retrorgb/COMP2DVI/Renders/comp2dvi2.1 Top no parts.png

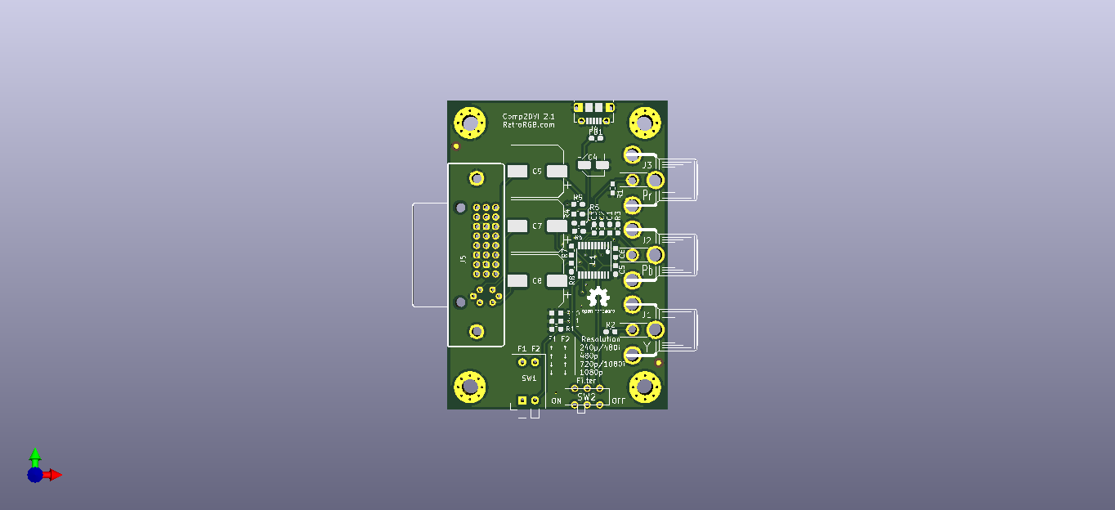
Renders/comp2dvi2.1 Top no parts.png
