retrorgb/COMP2DVI/README.md

# COMP2DVI
Please refer to the [COMP2DVI](https://www.retrorgb.com/comp2dvi.html) page on RetroRGB for more information.
