retrorgb/COMP2DVI/Renders/comp2dvi2.1 top.png

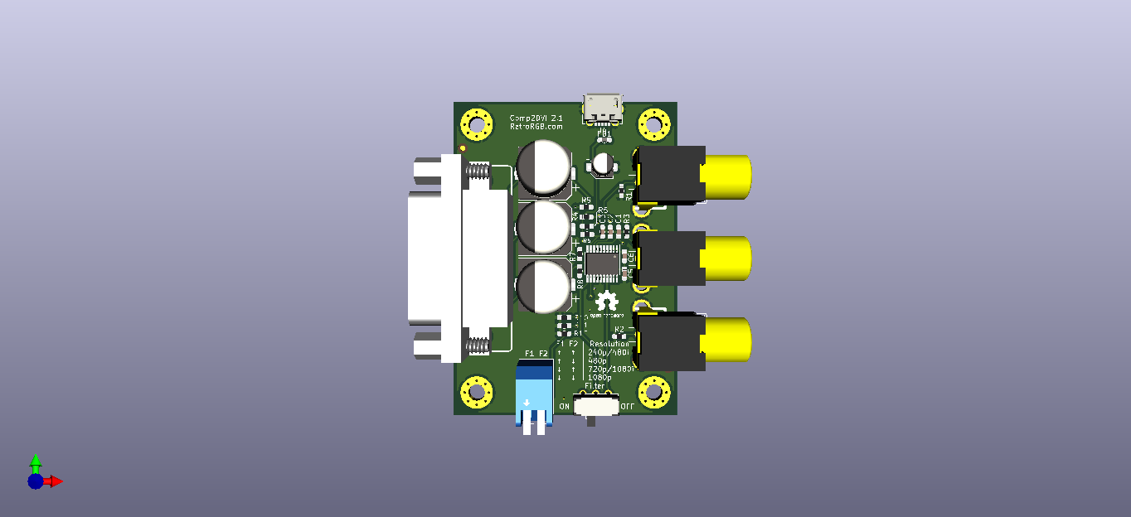
Renders/comp2dvi2.1 top.png
