retrorgb/COMP2DVI/COMP2DVI_BOM.xlsx

Qty | Reference(s) | Value | Footprint | Description | Digikey | Arrow | LCSC | Alternate Parts
4 | C1, C2, C3, C5 | 100nF/0.1uF | 0603 | Ceramic 50V X7R | https://www.digikey.com/product-detail/en/CL10F104ZO8NNNC/1276-1258-1-ND/3889344/ | https://www.arrow.com/en/products/cl10f104zo8nnnc/samsung-electro-mechanics | https://lcsc.com/product-detail/Multilayer-Ceramic-Capacitors-MLCC-SMD-SMT_100nF-104-10-50V_C14663.html
1 | C4 | 10 uF | 4x5.4 | Elec. 25-50V | https://www.digikey.com/product-detail/en/panasonic-electronic-components/EEE-FK1E100R/PCE3795CT-ND/766171 | https://www.arrow.com/en/products/eeefk1e100r/panasonic | https://lcsc.com/product-detail/Others_PANASONIC-EEE1EA100WAR_C336730.html
1 | C6 | 10nF | 0603 | Ceramic 50V X7R | https://www.digikey.com/product-detail/en/samsung-electro-mechanics/CL10B103KB8NCNC/1276-1921-1-ND/3890007 | https://www.arrow.com/en/products/cc0603krx7r9bb103/yageo | https://lcsc.com/product-detail/Others_Samsung-Electro-Mechanics_CL10B103KB8NFNC_Samsung-Electro-Mechanics-CL10B103KB8NFNC_C307477.html
3 | C7, C8, C9 | 470uF | 10x10 | Elec. 25V | https://www.digikey.com/product-detail/en/nichicon/UCW1E471MNL1GS/493-9424-1-ND/3962772 | https://www.arrow.com/en/products/uwg1e471mnl1gs/nichicon | https://lcsc.com/product-detail/Others_Nichicon-UCW1E471MNL1GS_C340751.html
1 | FB1 | 220Ω | 0603 | Ferrite Bead | https://www.digikey.com/product-detail/en/tdk-corporation/MPZ1608S221ATA00/445-1565-1-ND/571895 | https://www.arrow.com/en/products/mpz1608s221ata00/tdk | https://lcsc.com/product-detail/Ferrite-Beads-And-Chips_TDK_MPZ1608S221ATA00_220R-25-at100MHz_C76815.html
6 | R1, R2, R3, R7, R8, R9 | 75Ω | 0603 | 1% | https://www.digikey.com/product-detail/en/rohm-semiconductor/ESR03EZPF75R0/RHM75.0ADCT-ND/1983773 | https://www.arrow.com/en/products/erj-3ekf75r0v/panasonic | https://lcsc.com/product-detail/Chip-Resistor-Surface-Mount_75R-75R0-1_C112309.html
3 | R4, R5, R6 | 5.36M | 0603 | 1% | https://www.digikey.com/product-detail/en/vishay-dale/CRCW06035M36FKEA/541-5.36MHCT-ND/1180235 | https://www.arrow.com/en/products/crcw06035m36fkea/vishay |  | not available from lcsc
3 | R10, R11, R12 | 100K | 0603 | 1% | https://www.digikey.com/product-detail/en/yageo/RC0603FR-07100KL/311-100KHRCT-ND/729836 | https://www.arrow.com/en/products/erj-3ekf1003v/panasonic | https://lcsc.com/product-detail/Chip-Resistor-Surface-Mount_100KR-1003-1_C14675.html
1 | U1 | THS7368 | TSSOP-20 |  | https://www.digikey.com/product-detail/en/texas-instruments/THS7368IPWR/296-25625-1-ND/2202289 | https://www.arrow.com/en/products/ths7368ipw/texas-instruments | https://lcsc.com/product-detail/Operational-Amplifiers_TI_THS7368IPW_THS7368IPW_C206127.html
1 | SW1 | DIP Switch | 1x2 DIP | Piano | https://www.digikey.com/product-detail/en/omron-electronics-inc-emc-div/A6FR-2104/Z8808-ND/8575965 | https://www.arrow.com/en/products/a6fr2104/omron | https://lcsc.com/product-detail/DIP-Switches_Made-in-China-VPG1S-02H-R_C12544.html
1 | SW2 | Microswitch | SPDT |  | https://www.digikey.com/product-detail/en/c-k/JS202011AQN/401-2000-ND/1640096 | https://www.arrow.com/en/products/js202011aqn/ck | https://lcsc.com/product-detail/Toggle-Switches_C-K_JS202011AQN_C-K-JS202011AQN_C221662.html
1 | J1 | RCA Jack | 4 pin | Y (Green) | https://www.digikey.com/product-detail/en/RCJ-016/CP-1405-ND/408492/ | https://www.arrow.com/en/products/rcj-016/cui-inc
2 | J2 | RCA Jack | 4 pin | Pb (Blue) | https://www.digikey.com/product-detail/en/RCJ-015/CP-1404-ND/408491 | https://www.arrow.com/en/products/rcj-015/cui-inc
3 | J3 | RCA Jack | 4 pin | Pr (Red) | https://www.digikey.com/product-detail/en/cui-inc/RCJ-012/CP-1401-ND/408488 | https://www.arrow.com/en/products/rcj-012/cui-inc
1 | J4 | Micro USB | Micro USB |  | https://www.digikey.com/product-detail/en/molex/1050170001/WM1399CT-ND/2350885 | https://www.arrow.com/en/products/1050170001/molex | https://lcsc.com/product-detail/USB-Connectors_XKB-Enterprise-U254-051T-4BH23-S2B_C319164.html
1 | J5 | DVI-I | DVI-I |  | https://www.digikey.com/product-detail/en/molex-llc/0743201004/WM5600-ND/356066 | https://www.arrow.com/en/products/0743201004/molex | https://lcsc.com/product-detail/Audio-Video-Connectors_CONNFLY-Elec-DS1091-VN0X_C77847.html
2 | DVI SCREWS |  | #4 |  | https://www.digikey.com/product-detail/en/te-connectivity-amp-connectors/5207953-3/5207953-3-ND/1121976 | https://www.arrow.com/en/products/5207953-3/te-connectivity
 | Case Parts
4 | Top Standoffs | nylon | 12mm | M3 | https://www.digikey.com/en/supplier-centers/k/keystone-electronics |  | https://lcsc.com/product-detail/Studs_HIWA-HP-12M3-12_C123697.html | Brass is also ok
4 | Bottom Standoffs | nylon | 5mm | M3 | https://www.digikey.com/product-detail/en/harwin-inc/R30-6700594/952-1528-ND/2264509 |  | https://lcsc.com/product-detail/Studs_HIWA-HP-5M3-5_C123700.html
4 | bottom screws |  | 12mm | M3 | https://www.digikey.com/en/supplier-centers/a/apm-hexseal |  | https://lcsc.com/product-detail/Screw_Shuntian-PM3X12_C357546.html
4 | top screws |  | 8mm | M3 | https://www.digikey.com/en/supplier-centers/a/apm-hexseal |  | https://lcsc.com/product-detail/Screw_Shuntian-PM3X8_C357544.html
4 | rubber feet |  |  | M3 | https://www.digikey.com/product-detail/en/keystone-electronics/720/36-720-ND/61956 |  |  | https://www.amazon.com/gp/product/B07MBN4WSR/ref=ppx_yo_dt_b_search_asin_title?ie=UTF8&psc=1
