retrorgb/COMP2DVI/comp2dvi2.kicad_pcb

## KiCad design comp2dvi2.kicad_pcb (2019-06-26)

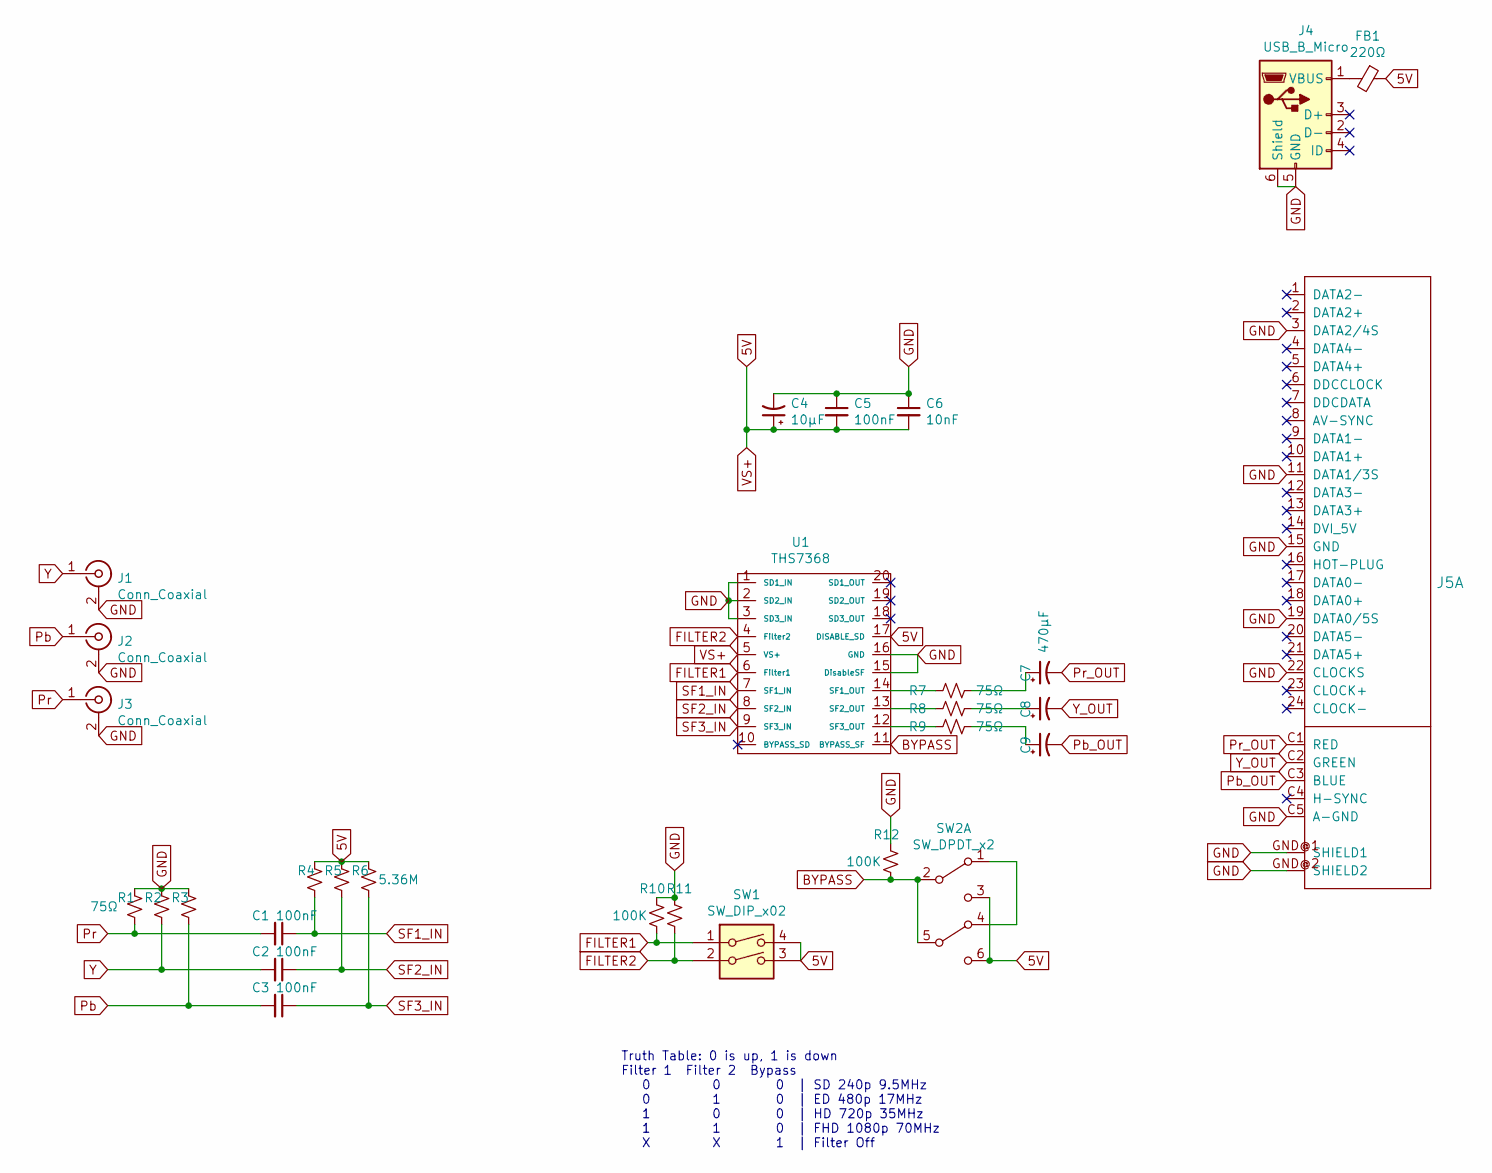
[picture p3: schematic comp2dvi2.sch, VGA2DVI]

Parts:
C1, C2, C3, C5: 100nF; C_0603_1608Metric_Pad1.05x0.95mm_HandSolder
C4: 10μF; CP_Elec_4x5.4
C6: 10nF; C_0603_1608Metric_Pad1.05x0.95mm_HandSolder
C7, C8, C9: 470μF; CP_Elec_10x10
FB1: 220Ω; L_0603_1608Metric_Pad1.05x0.95mm_HandSolder
J1, J2, J3: Conn_Coaxial; CIU_RCJ-01X
J4: USB_B_Micro; USB_Micro-B_Molex-105017-0001
J5: DVI-I-R
R1, R2, R3, R7, R8, R9: 75Ω; R_0603_1608Metric_Pad1.05x0.95mm_HandSolder
R4, R5, R6: 5.36M; R_0603_1608Metric_Pad1.05x0.95mm_HandSolder
R10, R11, R12: 100K; R_0603_1608Metric_Pad1.05x0.95mm_HandSolder
SW1: SW_DIP_x02; SW_DIP_SPSTx02_Piano_10.8x6.64mm_W7.62mm_P2.54mm
SW2: SW_DPDT_x2; JS202011
U1: THS7368; TSSOP-20_4.4x6.5mm_P0.65mm

Connections:
5V: C4.1, C5.2, C6.2, FB1.1, R4.1, R5.1, R6.1, SW1.3, SW1.4, SW2.3 (C), SW2.6 (C), U1.5 (VS+), U1.17 (DISABLE_SD)
BYPASS: R12.2, SW2.2 (B), SW2.5 (B), U1.11 (BYPASS_SF)
FILTER1: R10.2, SW1.1, U1.6 (Filter1)
FILTER2: R11.2, SW1.2, U1.4 (Filter2)
GND: C4.2, C5.1, C6.1, J1.2 (Ext), J2.2 (Ext), J3.2 (Ext), J4.5 (GND), J4.6 (Shield), J5.3 (DATA2/4S), J5.11 (DATA1/3S), J5.15 (GND), J5.19 (DATA0/5S), J5.22 (CLOCKS), J5.C5 (A-GND), J5.GND@1 (SHIELD1), J5.GND@2 (SHIELD2), R1.1, R2.1, R3.1, R10.1, R11.1, R12.1, U1.1 (SD1_IN), U1.2 (SD2_IN), U1.3 (SD3_IN), U1.15 (DisableSF), U1.16 (GND)
unnamed: C7.1, R7.1
unnamed: C8.1, R8.1
unnamed: C9.1, R9.1
unnamed: FB1.2, J4.1 (VBUS)
unnamed: R7.2, U1.14 (SF1_OUT)
unnamed: R8.2, U1.13 (SF2_OUT)
unnamed: R9.2, U1.12 (SF3_OUT)
unnamed: SW2.1 (A), SW2.4 (A)
Pb: C3.2, J2.1 (In), R3.2
Pb_OUT: C9.2, J5.C3 (BLUE)
Pr: C1.2, J3.1 (In), R1.2
Pr_OUT: C7.2, J5.C1 (RED)
SF1_IN: C1.1, R4.2, U1.7 (SF1_IN)
SF2_IN: C2.1, R5.2, U1.8 (SF2_IN)
SF3_IN: C3.1, R6.2, U1.9 (SF3_IN)
Y: C2.2, J1.1 (In), R2.2
Y_OUT: C8.2, J5.C2 (GREEN)

Notes on the sheet:
Truth Table: 0 is up, 1 is down Filter 1 Filter 2 Bypass 0 0 0 | SD 240p 9.5MHz 0 1 0 | ED 480p 17MHz 1 0 0 | HD 720p 35MHz 1 1 0 | FHD 1080p 70MHz X X 1 | Filter Off

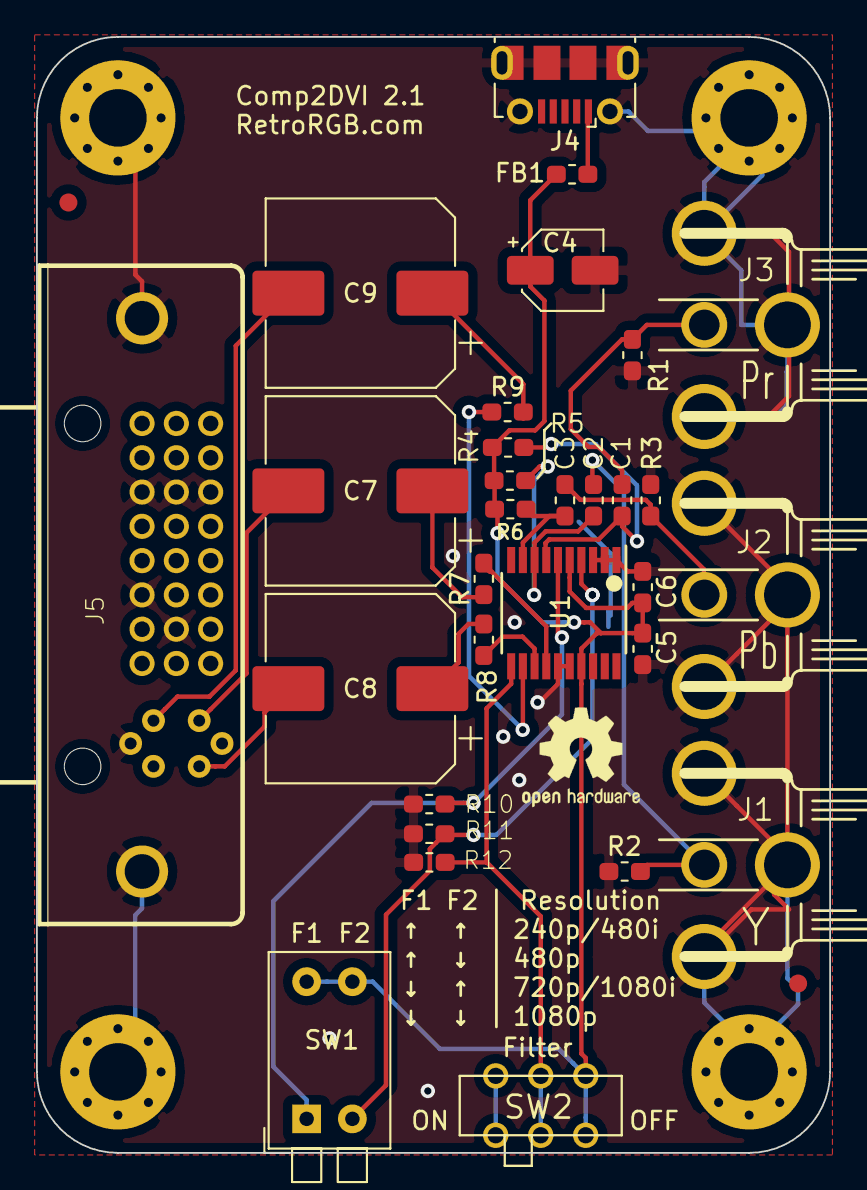
[picture p4: board comp2dvi2.kicad_pcb from above]

Board: 2 copper layers, 44.1 x 62.0 mm, 30 parts (0 on the bottom side), 22 nets.
