retrorgb/COMP2DVI/(commit log)

2019-06-13 Initial Eagle Version
    Initial Eagle version of the Comp2DVI
    [Component to DVI-A Compact.brd, Component to DVI-A Compact.sch]
2019-06-13 Converted to KiCAD
    [Component to DVI-A Compact.brd, Component to DVI-A Compact.kicad_pcb, Component to DVI-A Compact.sch]
2019-06-13 2.1 version
    Changed to THS7368 amp. This involced adding a dip switch and selector switch to determine the bandwidth of the video filter. Changed micro-usb port to a more commonly available part.
    [COMP2DVI_BOM.xlsx, Component to DVI-A Compact.kicad_pcb, _saved_comp2dvi2.sch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]
2019-06-17 Bypass Cap Routing
    Fixed routing so that the power from the USB goes to the 100nF bypass cap before hitting the chip. Thanks to Tianfeng for pointing this out. Gerbers updated as well.
    [_saved_comp2dvi2.sch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]
2019-06-17 renamed gerber zip
2019-06-26 Fixed overlapping silkscreen
    Fixed overlap, won't change version number or make a new release for this.
    [comp2dvi2-B_Cu.gbl, comp2dvi2-B_Mask.gbs, comp2dvi2-B_SilkS.gbo, comp2dvi2-Edge_Cuts.gm1, comp2dvi2-F_Cu.gtl, comp2dvi2-F_Mask.gts, comp2dvi2-F_Paste.gtp, comp2dvi2-F_SilkS.gto]
2019-08-18 Updated BOM
    BOM now matches current version and includes case hardware.
    [COMP2DVI_BOM.xlsx]
2019-10-24 removed old files
    [comp2dvi2.sch]
