retrorgb/COMP2DVI/(notices)

Notices in the files:
comp2dvi2.kicad_pcb:
Licensed Under CERN OHL 1.2
